rafi300604/KAWAL_GPS-TRACKER-APP/(commit log)

2026-09-10 Initial commit: GPS Tracker App
    Skripsi GPS tracking system - Flutter app (web/Android/iOS) + FastAPI
    backend + ESP32 firmware contract. ESP32 (LilyGo T-Call A7670E, GNSS+GSM)
    reports position via GSM to a FastAPI/PostgreSQL backend (device API key
    auth); the app polls it for live position, history playback, and ETA to
    user-defined waypoints, alongside Firebase Auth for login and Firestore
    for waypoints.
2026-09-10 Migrate auth/users/waypoints from Firebase to self-hosted FastAPI backend
    Adds JWT-based login, user management, and waypoint CRUD endpoints to
    the FastAPI backend, and switches the Flutter app to use them instead
    of Firebase Auth/Firestore. Waypoint live updates now use polling
    instead of a snapshot listener. Retires functions/, firebase.json,
    firestore.rules/indexes, and firebase_options.dart, which are fully
    superseded. Also rebrands the app to KAWAL (header logo, launcher
    name, splash screen) and removes the debug "simulate ESP32" button.
    Claude-Session: https://claude.ai/code/session_01Hw8mC3RjKcXBpL78RbeVTU
2026-09-10 Make waypoint add/remove update the map/ETA panel instantly
    DeviceService.watchWaypoints() now backs onto a StreamController instead
    of a raw polling generator, so addWaypoint()/removeWaypoint() can push a
    fresh fetch straight into it as soon as the request succeeds - the ETA
    panel and route no longer wait for the next 5s poll tick to reflect a
    change. Home screen also opens the ETA panel automatically the moment a
    waypoint is saved, instead of requiring a separate tap on "ETA".
    Also updates README.md and FIRMWARE_CONTRACT.md to describe the current
    FastAPI-backed architecture (login/users/waypoints all migrated off
    Firebase) instead of the stale Firebase Auth/Firestore description.
    Co-Aut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
2026-09-10 Make ETA panel content truly instant, fix two related bugs found live
    Three real causes were stacked behind the "ETA masih lama muncul"
    complaint, found and fixed by testing the actual save/remove flow live:
    1. EtaPanel blocked its whole body behind a spinner while the OSRM road
    route was loading, even though waypoints/distance were already known.
    It now always shows rows immediately (straight-line fallback, computed
    locally with zero network calls) and upgrades them in place once the
    real road route resolves.
    2. watchWaypoints() returned a plain broadcast stream, which never replays
    past events to late subscribers. The ETA panel's StreamBuilder mounts
    only after _showEta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
2026-09-10 Fix RenderFlex overflow in ETA panel on iOS
    Each waypoint row's "Jarak: X km ETA: X menit" line was a plain Row
    with no Expanded/Flexible, sized just barely within the 300px-wide
    panel. iOS's system font renders that text a fraction of a pixel wider
    than on Android, tipping it into a "RIGHT OVERFLOWED BY 0.386 PIXELS"
    render error (reported live via screenshot from an iOS device).
    Switched that line to a Wrap (falls to a second line instead of
    overflowing) and applied the same defensive fix to the Total Jarak/
    Total Waktu/Waktu Tiba summary rows, which had the identical
    Row-with-no-flex shape and were one platform-metric away from the same
    bug. Verified on Android: renders identically on o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
2026-09-10 Match Waypoint/ETA/History button layout on iOS to Android, iOS-only
    iOS's system font renders these three button labels slightly wider than
    Android's, which could push "History" onto a second Wrap row on iOS
    while Android always fits all three on one line - same code, different
    per-platform layout outcome.
    Added a Theme.of(context).platform == TargetPlatform.iOS check (guarded
    by two small helpers) that only trims icon size (18->16) and button
    padding/font size specifically on iOS, bringing its layout in line with
    Android's single-row arrangement. Guarded to iOS only by construction:
    on Android and web the check evaluates false, so style/icon size stay
    null/18 (identical to before) - verif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
2026-09-13 Add SIM-quota-low notifications, coordinated with the skripsi.ino session
    GSM modems have no AT command to read actual carrier data quota, so
    (per skripsi-9f's finding in FIRMWARE_CONTRACT.md) the firmware can only
    detect this heuristically - repeated GSM data-session failures despite
    normal network registration - and reports it by overloading the existing
    dataSource field with a descriptive string like
    "WIFI (GSM: kuota diduga habis)" rather than a numeric quota value.
    Backend:
    - Widened devices.data_source and telemetry.data_source from VARCHAR(10)
    to VARCHAR(50) - the old width would make /telemetry fail outright
    (StringDataRightTruncation, HTTP 500) the moment firmware sent a string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
2026-09-14 Add Sumber Daya/Sumber Data columns to tracking history export
    Both fields already existed per-device (devices.power_source/data_source,
    current state only), but the telemetry history table only ever stored
    data_source per row - power_source was never captured per-transmission,
    so history/export had no way to show it at all, current-only wouldn't
    reflect what was actually true at each historical point (e.g. a power
    source that changed over time).
    Backend: added telemetry.power_source (migration 0004), captured in
    ingest_telemetry() alongside data_source, exposed as powerSource in
    GET /telemetry/{sn}/history. Built, tested against an isolated container
    connected to the real DB (confirmed a f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
2026-09-14 Fall back to the device's current power source in export history
    The user reported exporting real history and seeing "-" for every row's
    Sumber Daya, while Sumber Data was correct. Root cause: those rows were
    recorded on 2026-09-10, four days before telemetry.power_source existed
    at all (added 2026-09-14) - there's no historical value to retrieve for
    them, null is accurate, not a bug.
    But a bare "-" reads as "data missing" when it's really "not captured
    before this field existed", and the device's physical power source
    essentially never changes transmission-to-transmission - so falling back
    to the device's currently-known power source (already available on the
    selected DeviceVessel) is a fa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
2026-09-14 Document that firmware never actually sends powerSource
    Checked all 324 telemetry rows for ESP32-01 - every single one is NULL,
    including transmissions received today, well after backend/app were
    ready to store and display this field per-point. powerSource was already
    part of the /telemetry contract (not new), so this is a firmware gap to
    flag for skripsi.ino, not a backend/app bug.
    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
2026-10-23 Remove hardcoded credentials and add the ESP32 firmware
    Prepares the repository to be made public. The backend API keys and the
    tester login are no longer in source: the app reads them at build time
    via --dart-define-from-file=secrets.json (git-ignored; see
    secrets.example.json), and the Login Cepat shortcut only appears in
    debug/profile builds when tester credentials are supplied.
    The ESP32 firmware (firmware/skripsi/skripsi.ino) is added with its
    device and MQTT credentials moved to a git-ignored secrets.h; see
    secrets.example.h. The tester password that appeared in older commits
    has been changed on the production server, and the API keys in older
    commits belong to a retired server.
    Co-A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
2026-10-28 Add MPU6050 low-pass filter and data-path monitor to firmware
    - DLPF_CFG=4 (accel 21 Hz / gyro 20 Hz) damps engine and road vibration
    while lift/forced-open motions still reach the tamper algorithm.
    - Check GSM and WiFi every second; on a change switch straight to WiFi
    MQTT, or buffer points immediately when no path is left instead of
    waiting 2x60 s in gsmConnect().
    - GSM reconnect no longer blocks 60 s without signal, so GPS points in a
    blank spot are still read and buffered.
2026-11-02 Report device online status and register an offline Last Will
    The firmware now publishes "online" to status/<SN> after every MQTT
    connect (GSM and WiFi) and registers a Last Will "offline" on the same
    topic, so the broker announces a power cut or lost signal on its own.
    The GSM keepalive drops from the library default of 60 s to 30 s, so the
    Will arrives about 45 s after the device dies instead of about 90 s.
    This needs backend 2c5db33 and the broker ACL line pattern write status/%c,
    both already live.
2026-11-02 Bring the app repo up to the tested dashboard: live status, full history, alerts
    This syncs the app with the build used for the Tabel 4.4 web tests on
    2026-11-01, including app work that had only existed locally:
    - Device position polls every 1 s (was 3 s); polls still push to the UI only
    when data changes, so the map does not rebuild every tick.
    - History requests ask for every point since the chosen range (backend
    ad0f17e) instead of the latest 500, so longer ranges draw in full.
    - DeviceVessel.online from the backend status topic: the panel shows
    Offline and pop-ups announce disconnects and reconnects.
    - Tamper alerts with siren sound and map marker, the alert history dialog,
    rem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
2026-11-03 Bring the docs up to the current MQTT architecture
    The README diagram still showed the device posting over HTTPS and the
    app polling every 5 s, and several files pointed at the retired
    gps.jejakpintar.cloud domain. The README now shows device -> MQTT/TLS
    broker -> FastAPI/PostgreSQL and the app's 1 s REST polling, and lists
    the current features (tamper alarm, alerts, Offline status, place
    search) and device modes. FIRMWARE_CONTRACT.md opens with a summary of
    the contract in force, with the older sections kept as history. The
    backend README mirror is synced, and stale comments in
    backend_config.dart and the firmware header are corrected (comment
    only; the firmware compiles to the same size).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
